iandodson/DEN161_GameControllerDesign/Game Controller/Bumper/PB400EEQR1BLK/PB400EEQR1BLK.step

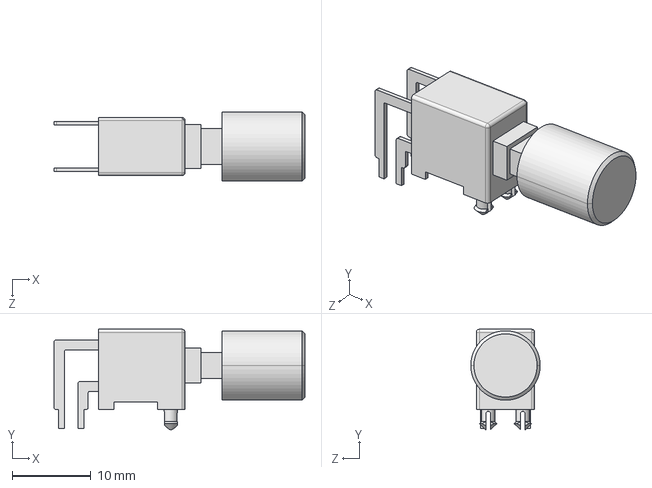
[picture p7: CAD file, 2026-09-24]
Game Controller/Bumper/PB400EEQR1BLK/PB400EEQR1BLK.step
31.8 x 12.7 x 8.80 mm
