iandodson/DEN161_GameControllerDesign/Game Controller/Group 7 - Game Controller/Game Controller.kicad_pcb

## KiCad design Game Controller/Group 7 - Game Controller/Game Controller.kicad_pcb (2026-09-24)

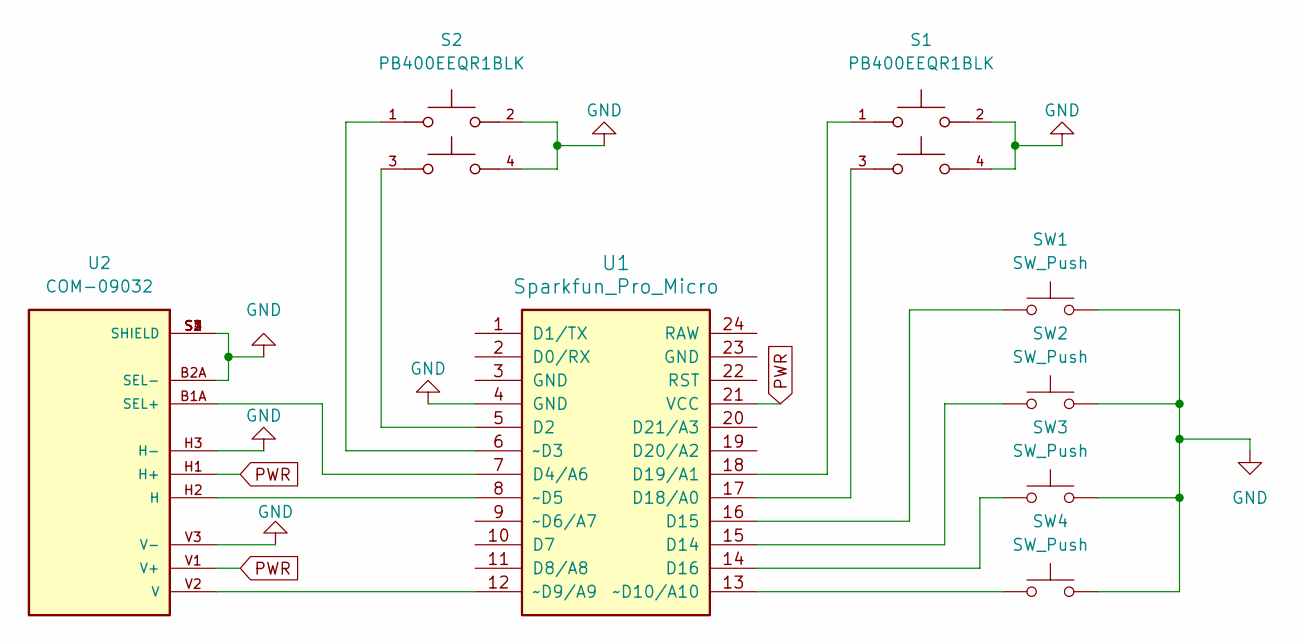
[picture p8: schematic Game Controller.kicad_sch]

Parts:
S1, S2: PB400EEQR1BLK; SW_PB400EEQR1BLK; PARTREV A
SW1, SW2, SW3, SW4: SW_Push; SW_Cherry_MX_1.00u_PCB
U1: Sparkfun_Pro_Micro
U2: COM-09032; XDCR_COM-09032; PARTREV N/A; DigiKey_Part_Number 1568-1526-ND

Connections:
GND: S1.2, S1.4, S2.2, S2.4, SW1.2, SW2.2, SW3.2, SW4.2, U1.4 (GND), U2.B2A (SEL-), U2.H3 (H-), U2.S1 (SHIELD), U2.S2 (SHIELD), U2.S3 (SHIELD), U2.S4 (SHIELD), U2.V3 (V-)
unnamed: S2.3, U1.5 (D2)
unnamed: U1.7 (D4/A6), U2.B1A (SEL+)
unnamed: SW2.1, U1.15 (D14)
unnamed: SW1.1, U1.16 (D15)
unnamed: SW3.1, U1.14 (D16)
unnamed: S1.3, U1.17 (D18/A0)
unnamed: S1.1, U1.18 (D19/A1)
unnamed: S2.1, U1.6 (~D3)
unnamed: U1.8 (~D5), U2.H2 (H)
unnamed: U1.12 (~D9/A9), U2.V2 (V)
unnamed: SW4.1, U1.13 (~D10/A10)
PWR: U1.21 (VCC), U2.H1 (H+), U2.V1 (V+)

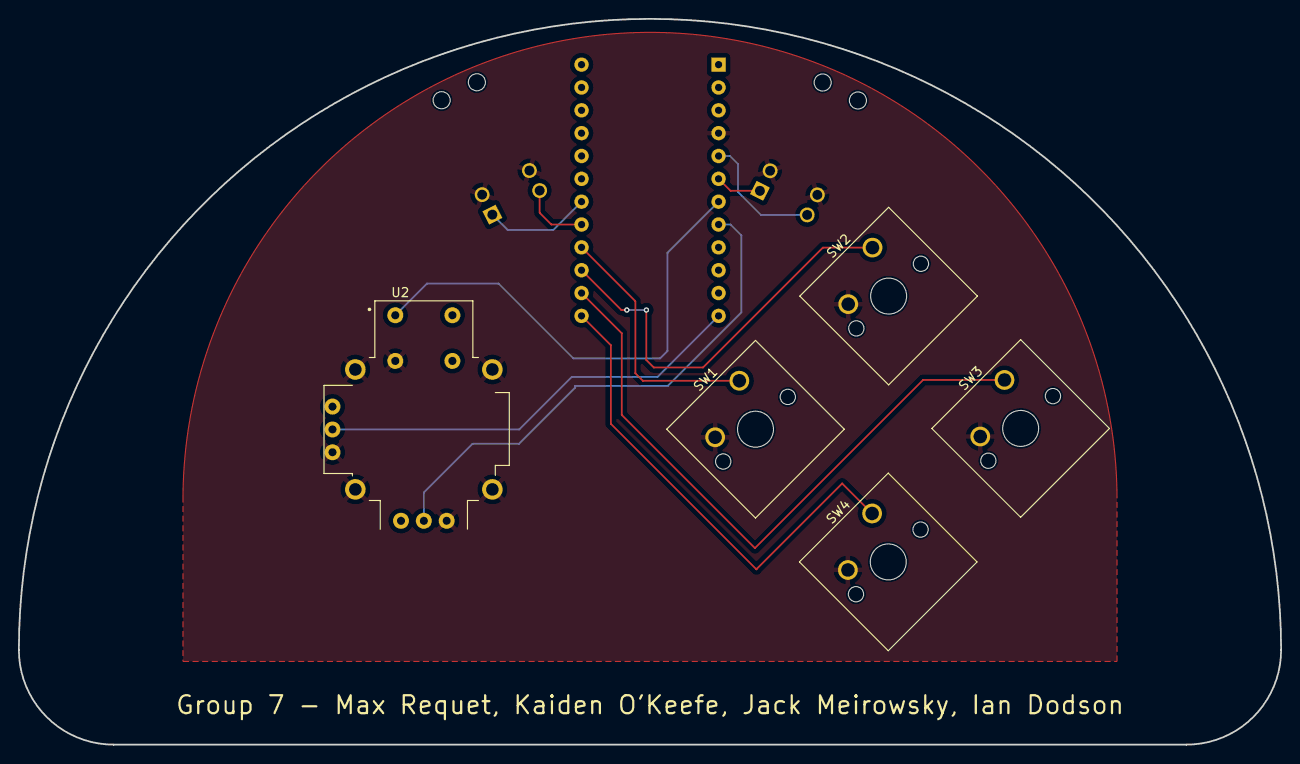
[picture p9: board Game Controller.kicad_pcb from above]

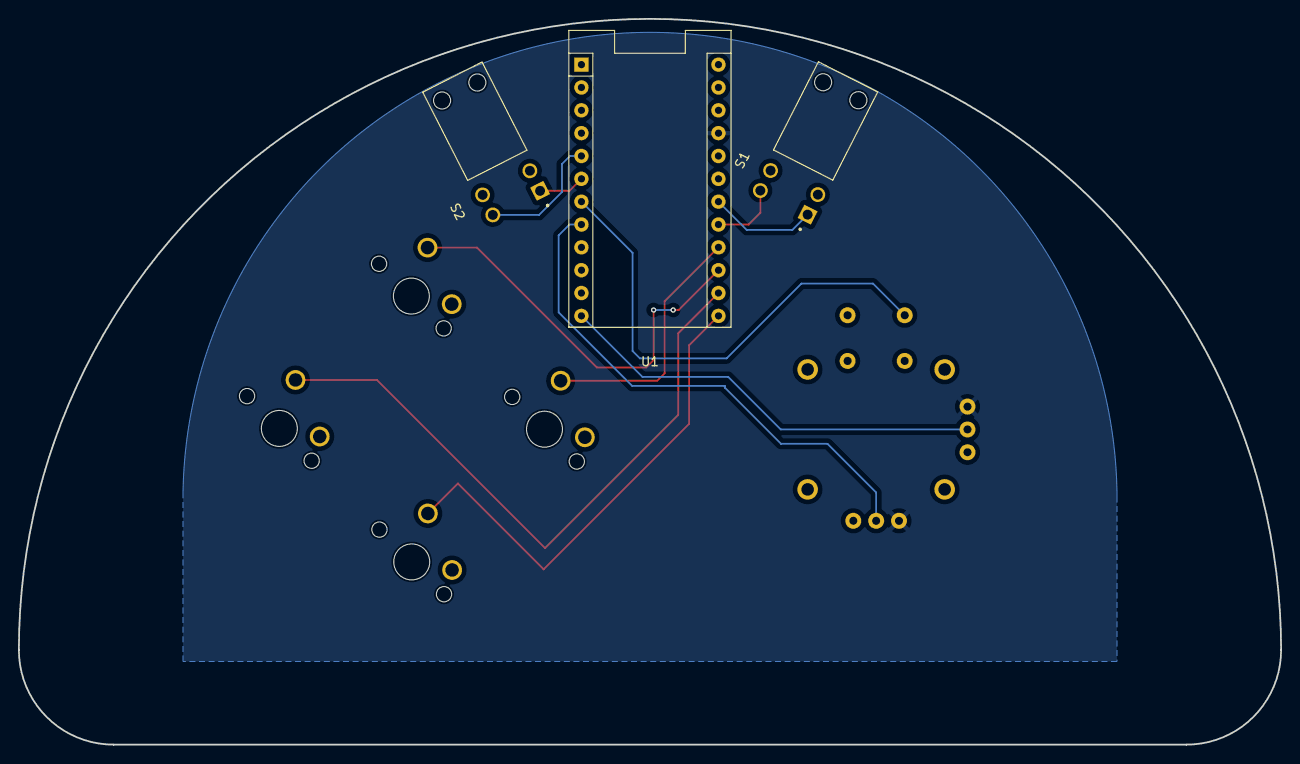
[picture p10: board Game Controller.kicad_pcb from below]

Board: 2 copper layers, 140.4 x 80.7 mm, 8 parts (3 on the bottom side), 13 nets.
