iandodson/DEN161_GameControllerDesign/Instruction Manual (Red).pdf

## DEN 161 - Group 7

# Controller User Manuel

## Instructor - Chase Harvey

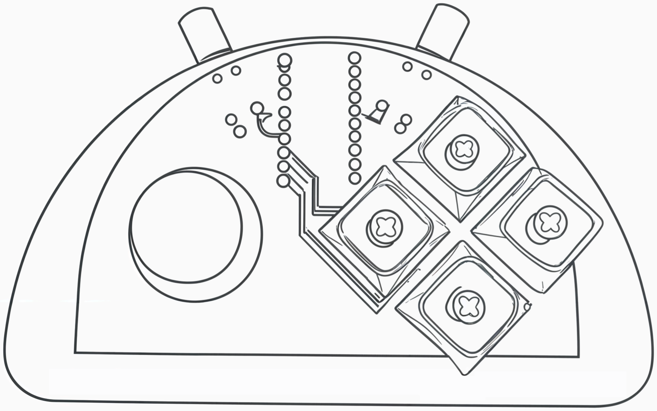
[picture p11: figure]

Jack Meir, Max Requet, Kaiden O’Keefe, Ian Dodson

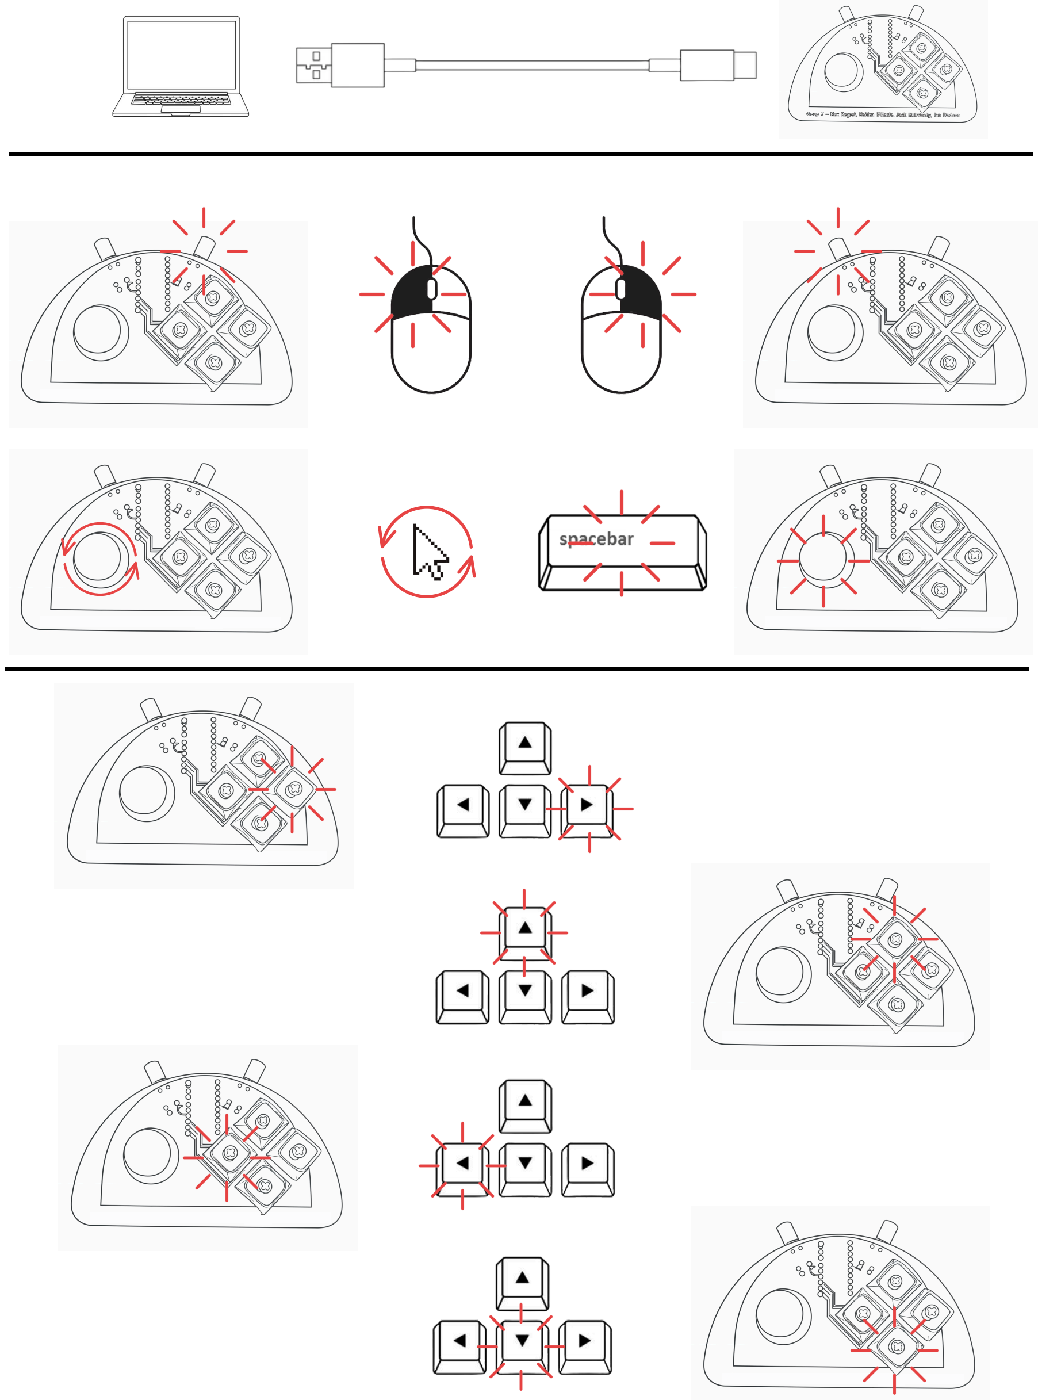
[picture p12: page 2]
